jakubtemr/ledCube/README.md

# Projekt ledCube s Arduino Uno

# Postup práce:
1. Sbírání informací o hardware-
2. příprava hardware-
3. Pájení
4. Pájení
5. Pájení
6. Testování
7. Opravy
8. Nahrání kodu do arduina a test s arduinem
9. Ladění
10. Výroba podstavce
11. Dokončení

# Zdroje
- http://www.pyroelectro.com/projects/8x8x8_led_cube/hardware3.html
- http://www.instructables.com/id/Led-Cube-8x8x8/
- http://www.instructables.com/id/8x8x8-Arduino-LED-Cube/
- http://www.jameco.com/Jameco/workshop/JamecoFavorites/8x8x8-led-cube.html
- https://www.youtube.com/watch?v=T5Aq7cRc-mU

20.9
# Seznam komponentů:
- 5mm diffused blue LEDs x 512 -
- 20 AWG tinned copper wire
- 5V 10A regulated switching power supply -
- Ribbon cables 
- PN2222 transistors x 16 -
- 220 ohm resistors x 64 -
- 74HC595 shift registers x 9 -
- Arduino Uno R3 -
- Prototyping board -
- Wires -
- Buttons
- Red LED -
- Green LED -

 10.10
- již přišly transistory,posuvné registry, vývojová deska a odpory
- nyní čekám na ledky, poté se pustím do pájení

 11.10
- navrh schematu

19.12
- všech 8 vrstev už je popájeno, je třeba sehnat nějaký vyhovující podstavec. bez něho nemůžu popájet vrstvy dohromady
- vygenerováno schéma v eagle. generovaní desky nevyhovuje, konzultace s panem Godovským/Grussmannem
- 22.12 práce hotová
- 28.12 dokumentace poslána panu Lučnému
