jakubtemr/ledCube/schema.pdf

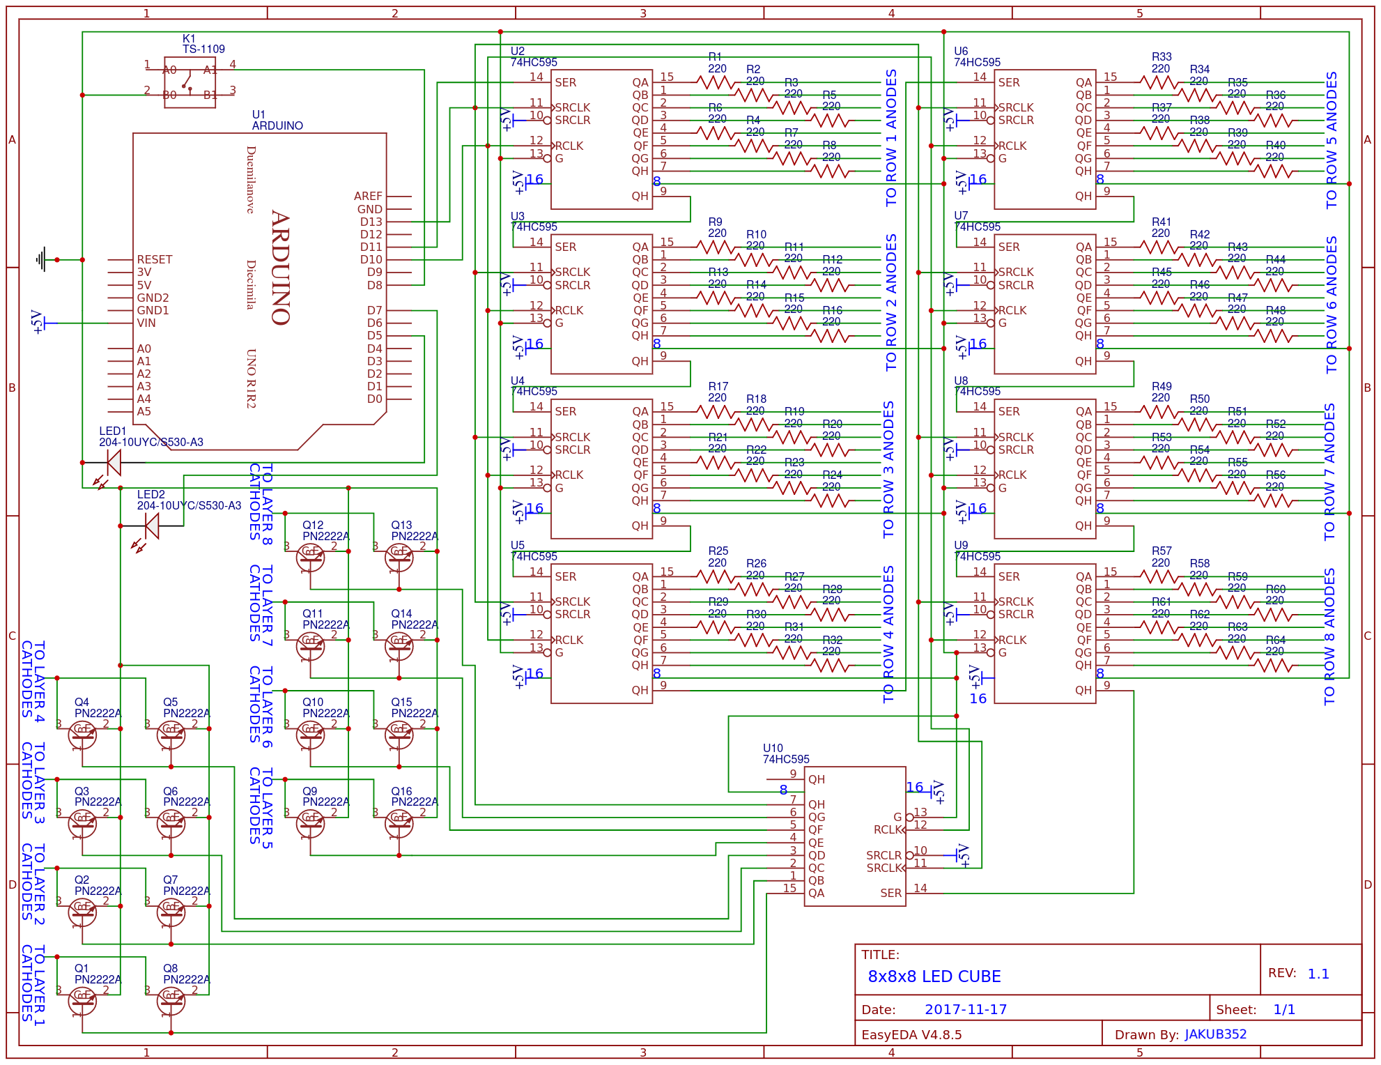
[picture p12: page 1]

JAKUB352
