jakubtemr/ledCube/Schema.png

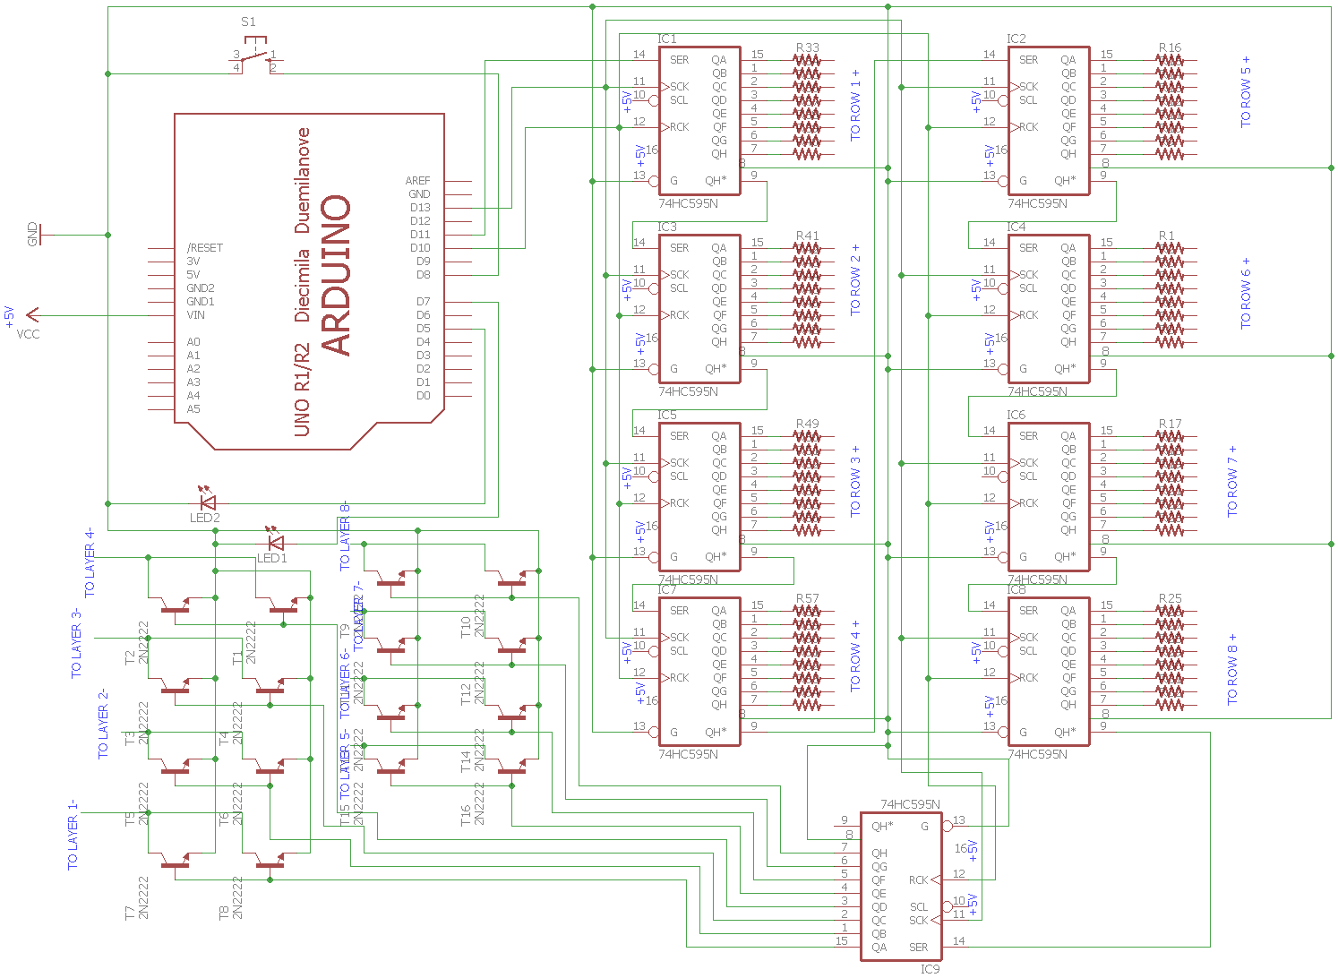
Schema.png
