jakubtemr/ledCube/ledCube.sch

## EAGLE design ledCube.sch (2017-12-19)

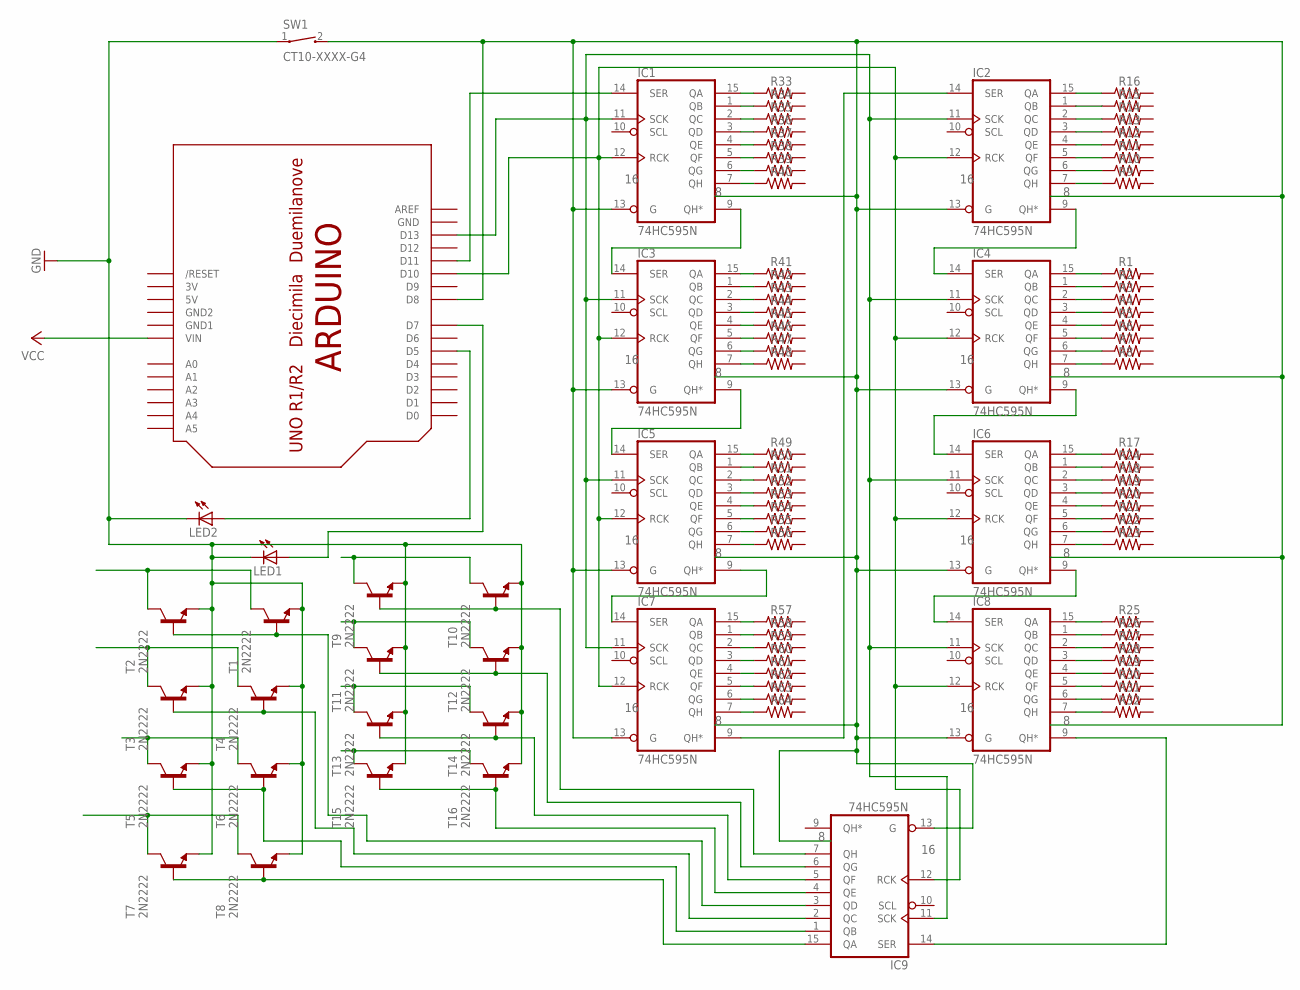
[picture p14: schematic ledCube.sch]

Parts:
IC1, IC2, IC3, IC4, IC5, IC6, IC7, IC8, IC9: 74HC595N; DIL16
LED1, LED2: LED; SMARTLED-TTW
R1, R2, R3, R4, R5, R6, R7, R8, R9, R10, R11, R12, R13, R14, R15, R16, R17, R18, R19, R20, R21, R22, R23, R24, R25, R26, R27, R28, R29, R30, R31, R32, R33, R34, R35, R36, R37, R38, R39, R40, R41, R42, R43, R44, R45, R46, R47, R48, R49, R50, R51, R52, R53, R54, R55, R56, R57, R58, R59, R60, R61, R62, R63, R64: RES-0207/10; 0207/10
SW1: CT10-XXXX-G4
T1, T2, T3, T4, T5, T6, T7, T8, T9, T10, T11, T12, T13, T14, T15, T16: 2N2222; TO92-EBC-OVAL
U$1: ARDUINO-BPLACE

Connections:
GND: LED1.C@1 (C), LED2.C@1 (C), SW1.1, T1.E, T2.E, T3.E, T4.E, T5.E, T6.E, T7.E, T8.E, T9.E, T10.E, T11.E, T12.E, T13.E, T14.E, T15.E, T16.E
unnamed: IC1.11 (SCK), IC2.11 (SCK), IC3.11 (SCK), IC4.11 (SCK), IC5.11 (SCK), IC6.11 (SCK), IC7.11 (SCK), IC8.11 (SCK), IC9.11 (SCK), U$1.D13
unnamed: IC1.14 (SER), U$1.D11
unnamed: IC1.9 (QH*), IC3.14 (SER)
unnamed: IC1.13 (G), IC2.13 (G), IC3.13 (G), IC4.13 (G), IC5.13 (G), IC6.13 (G), IC7.13 (G), IC8.13 (G), IC9.13 (G), SW1.2, U$1.D8
unnamed: LED1.A@1 (A), U$1.D7
unnamed: LED2.A@1 (A), U$1.D5
unnamed: IC9.15 (QA), T7.B, T8.B
unnamed: IC3.15 (QA), R41.1
unnamed: IC9.1 (QB), T5.B, T6.B
unnamed: IC9.2 (QC), T3.B, T4.B
unnamed: IC9.3 (QD), T1.B, T2.B
unnamed: IC9.4 (QE), T15.B, T16.B
unnamed: IC9.5 (QF), T13.B, T14.B
unnamed: IC9.6 (QG), T11.B, T12.B
unnamed: IC9.7 (QH), T9.B, T10.B
unnamed: T1.C, T2.C
unnamed: T3.C, T4.C
unnamed: T5.C, T6.C
unnamed: T7.C, T8.C
unnamed: T9.C, T10.C
unnamed: T11.C, T12.C
unnamed: T13.C, T14.C
unnamed: T15.C, T16.C
unnamed: IC8.9 (QH*), IC9.14 (SER)
unnamed: IC1.12 (RCK), IC2.12 (RCK), IC3.12 (RCK), IC4.12 (RCK), IC5.12 (RCK), IC6.12 (RCK), IC7.12 (RCK), IC8.12 (RCK), IC9.12 (RCK), U$1.D10
unnamed: IC3.9 (QH*), IC5.14 (SER)
unnamed: IC5.9 (QH*), IC7.14 (SER)
unnamed: IC2.14 (SER), IC7.9 (QH*)
unnamed: IC2.9 (QH*), IC4.14 (SER)
unnamed: IC4.9 (QH*), IC6.14 (SER)
unnamed: IC6.9 (QH*), IC8.14 (SER)
unnamed: IC4.15 (QA), R1.1
unnamed: IC4.1 (QB), R2.1
unnamed: IC4.2 (QC), R3.1
unnamed: IC4.3 (QD), R4.1
unnamed: IC4.4 (QE), R5.1
unnamed: IC4.5 (QF), R6.1
unnamed: IC4.6 (QG), R7.1
unnamed: IC4.7 (QH), R8.1
unnamed: IC2.7 (QH), R9.1
unnamed: IC2.6 (QG), R10.1
unnamed: IC2.5 (QF), R11.1
unnamed: IC2.4 (QE), R12.1
unnamed: IC2.3 (QD), R13.1
unnamed: IC2.2 (QC), R14.1
unnamed: IC2.1 (QB), R15.1
unnamed: IC2.15 (QA), R16.1
unnamed: IC6.15 (QA), R17.1
unnamed: IC6.2 (QC), R18.1
unnamed: IC6.3 (QD), R19.1
unnamed: IC6.4 (QE), R20.1
unnamed: IC6.5 (QF), R21.1
unnamed: IC6.6 (QG), R22.1
unnamed: IC6.7 (QH), R23.1
unnamed: IC6.1 (QB), R24.1
unnamed: IC8.15 (QA), R25.1
unnamed: IC8.1 (QB), R26.1
unnamed: IC8.2 (QC), R27.1
unnamed: IC8.3 (QD), R28.1
unnamed: IC8.4 (QE), R29.1
unnamed: IC8.5 (QF), R30.1
unnamed: IC8.6 (QG), R31.1
unnamed: IC8.7 (QH), R32.1
unnamed: IC7.7 (QH), R64.1
unnamed: IC7.6 (QG), R63.1
unnamed: IC7.5 (QF), R62.1
unnamed: IC7.4 (QE), R61.1
unnamed: IC7.3 (QD), R60.1
unnamed: IC7.2 (QC), R59.1
unnamed: IC7.1 (QB), R58.1
unnamed: IC7.15 (QA), R57.1
unnamed: IC5.7 (QH), R56.1
unnamed: IC5.6 (QG), R55.1
unnamed: IC5.5 (QF), R54.1
unnamed: IC5.4 (QE), R53.1
unnamed: IC5.3 (QD), R52.1
unnamed: IC5.2 (QC), R51.1
unnamed: IC5.1 (QB), R50.1
unnamed: IC5.15 (QA), R49.1
unnamed: IC3.7 (QH), R48.1
unnamed: IC3.6 (QG), R47.1
unnamed: IC3.5 (QF), R46.1
unnamed: IC3.4 (QE), R45.1
unnamed: IC3.3 (QD), R44.1
unnamed: IC3.2 (QC), R43.1
unnamed: IC3.1 (QB), R42.1
unnamed: IC1.7 (QH), R40.1
unnamed: IC1.6 (QG), R39.1
unnamed: IC1.5 (QF), R38.1
unnamed: IC1.4 (QE), R37.1
unnamed: IC1.3 (QD), R36.1
unnamed: IC1.2 (QC), R35.1
unnamed: IC1.1 (QB), R34.1
unnamed: IC1.15 (QA), R33.1
VCC: U$1.VIN
